drewsum/KiCad_Custom_Libs_v6/3d_models/ABC0760A.stp

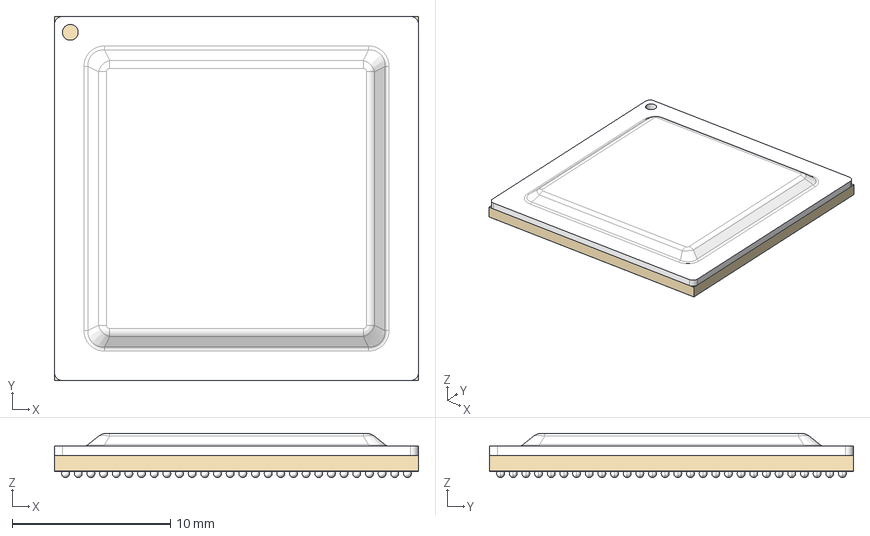
[picture p1: CAD file, 2022-11-27]
3d_models/ABC0760A.stp
23.0 x 23.0 x 2.79 mm
SUBSTRATE-BGA
SOLDER_BALL x 760
SMASK_BTM_BGA
HEATSPREADER-FCBGA
