drewsum/KiCad_Custom_Libs_v6/3d_models/ZWS0169A.stp

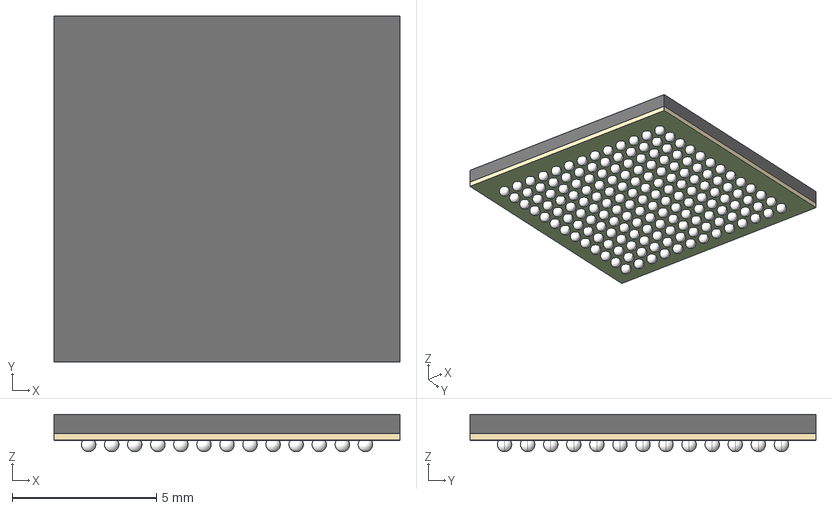
[picture p2: CAD file, 2022-11-27]
3d_models/ZWS0169A.stp
12.0 x 12.0 x 1.30 mm
SUBSTRATE_FBGA
SOLDER_BALL x 169
SMASK_BTM_FBGA
